dd3et/solar-grid-tie-inverter-MK2/IMAG8995.jpg

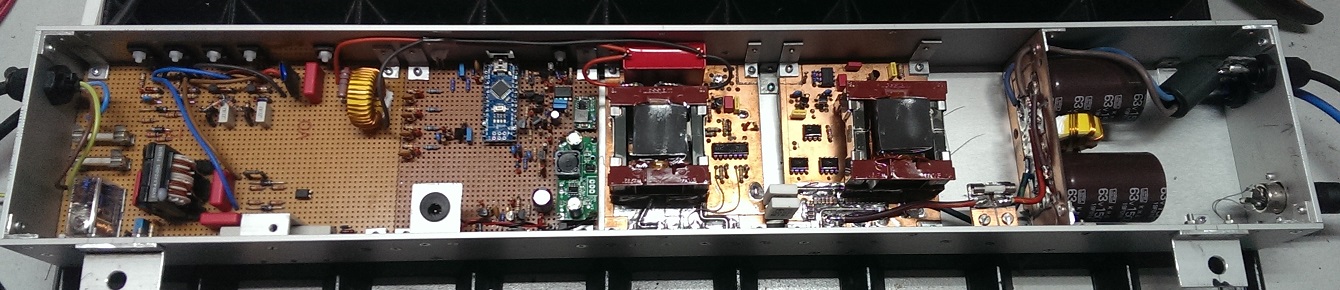
IMAG8995.jpg
