dd3et/solar-grid-tie-inverter-MK2/IMAG8998.jpg

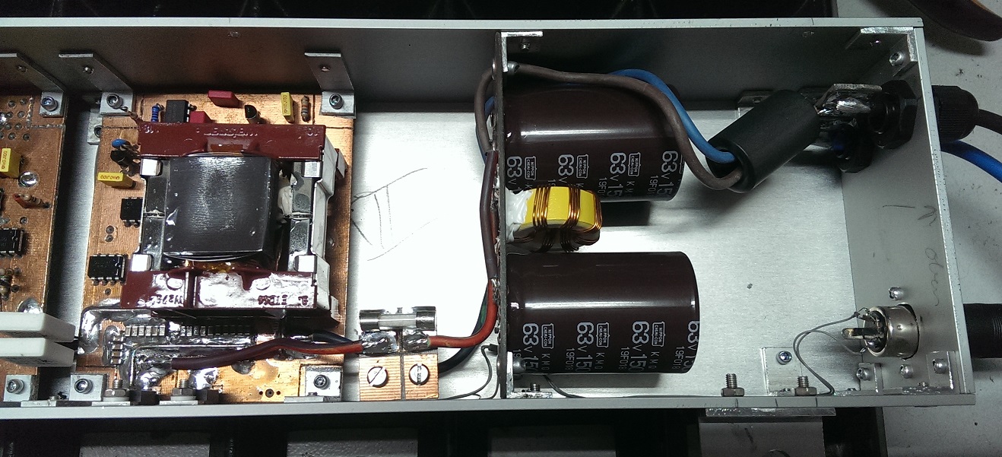
IMAG8998.jpg
