dd3et/solar-grid-tie-inverter-MK2/README.md

# solar-grid-tie-inverter-MK2
Solarwechselrichter für ein Modul wie JKM335M
Dieser Wechseltichter hat eine thermische Nachführung der mpp-Spannung des Solarmoduls.
Kein MPPT.
Unter das Modul wird mittig ein NTC geklebt, der mit dem Wechselrichter verbunden wird.
Der Wechselrichter wird unter dem Modul montiert.
die Begrenzung der Ausgangsleistung kann zwischen 50W ... 300W über den seriellen Monitor eingegeben werden.
Die MPP Spannung kann über den seriellen Monitor während des Betriebes eingegeben werden um den besten MPP zu finden.
Üner den seriellen Monitor werden diverse Betriebsparameter ausgegeben. u.A. die Ausgangsleistung und Modulspannung.
