dd3et/solar-grid-tie-inverter-MK2/IMAG8996.jpg

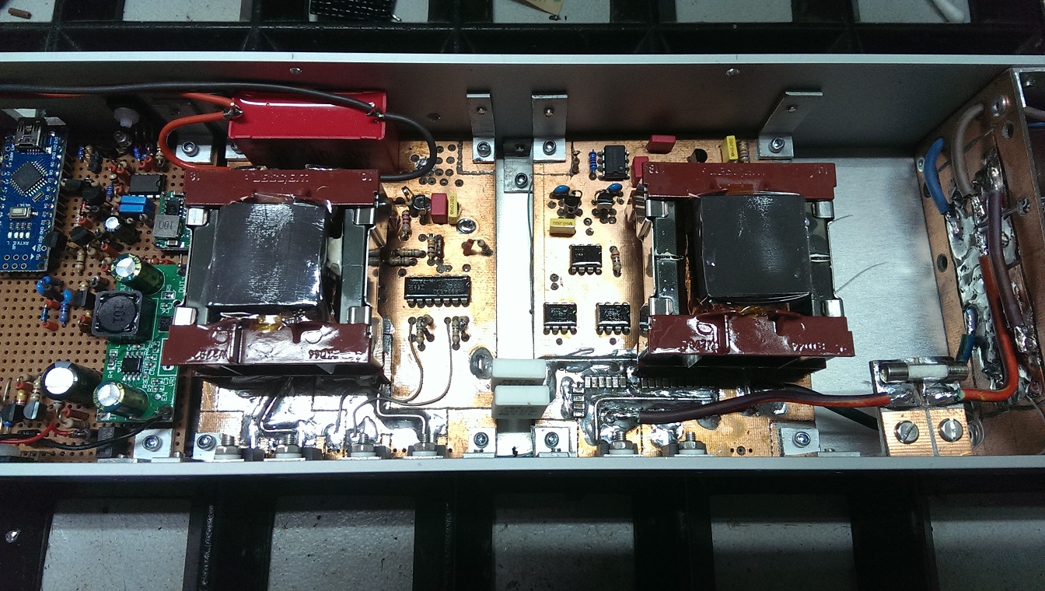
IMAG8996.jpg
