dd3et/solar-grid-tie-inverter-MK2/IMAG8997.jpg

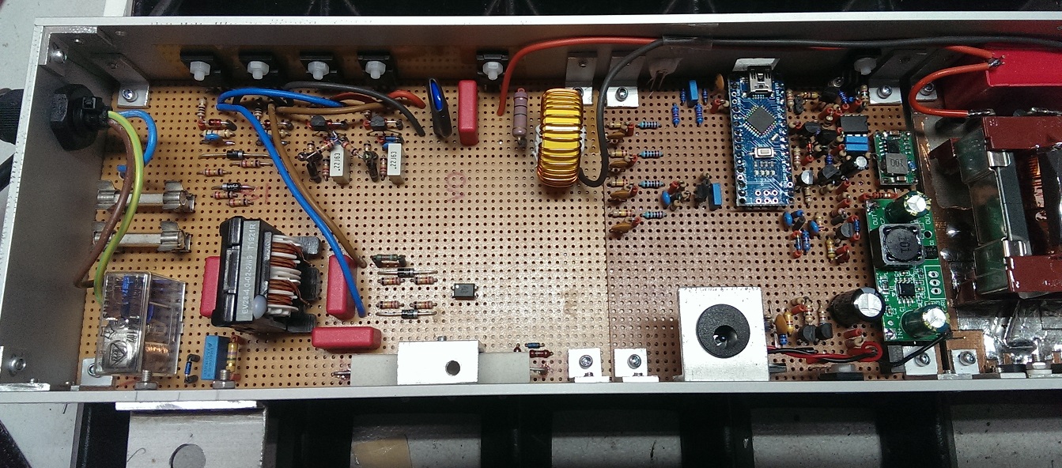
IMAG8997.jpg
