dd3et/solar-grid-tie-inverter-MK2/IMAG9004.jpg

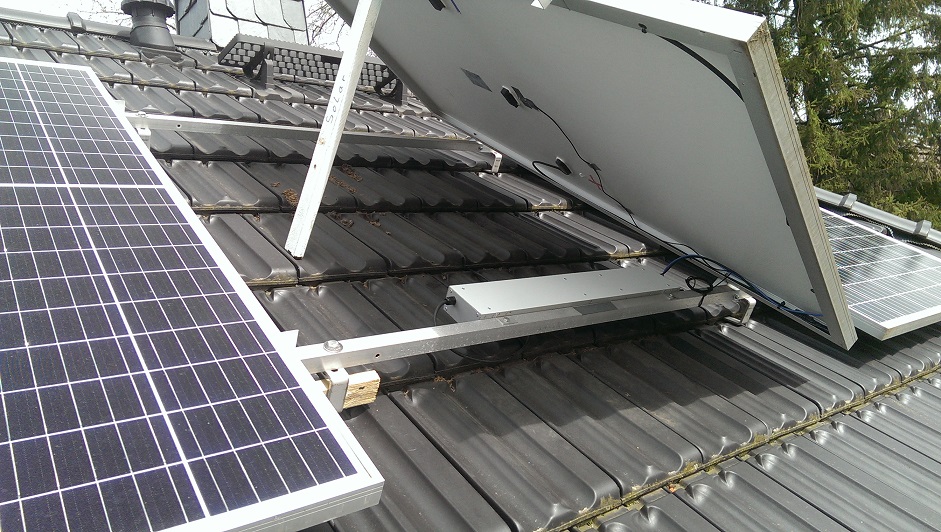
IMAG9004.jpg
