dd3et/solar-grid-tie-inverter-MK2/Solar-grid-tie-inverter-II-IRS-Buck-dcdc-conv-20240331-schema-2v2 .pdf

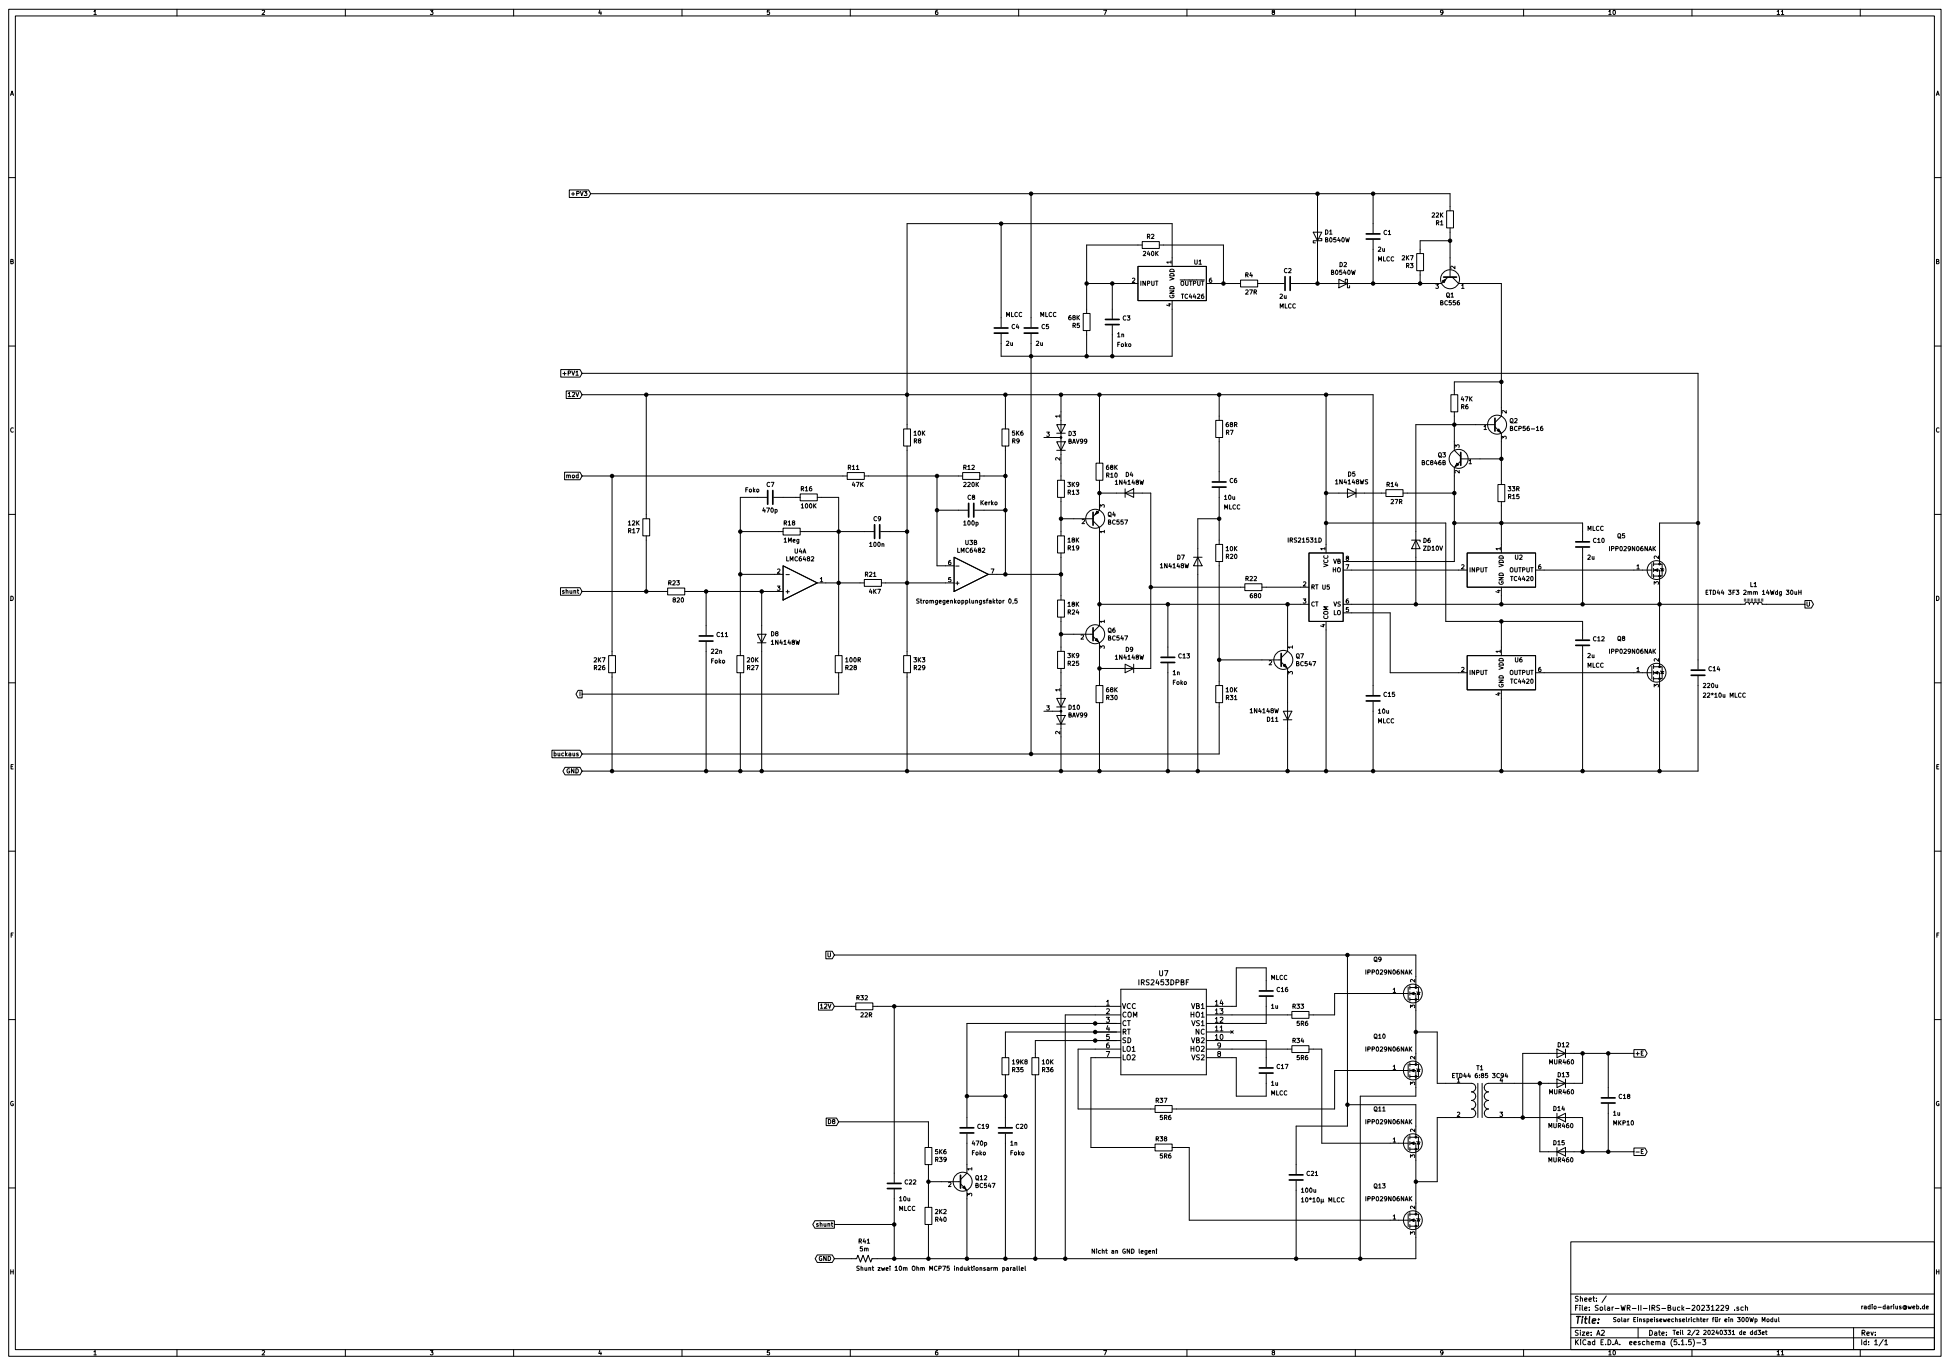
[picture p6: page 1]

7 VB
6 HO 5 VS

Nicht an GND legen!

Shunt zwei 10m Ohm MCP75 induktionsarm parallel

Id: 1/1 Title: File: Solar-WR-II-IRS-Buck-20231229 .sch Sheet: /

radio-darius@web.de
