dd3et/solar-grid-tie-inverter-MK2/Solar-grid-tie-inverter-II-U-Versorgung-Einspeise-20240331-schema-1v2.pdf

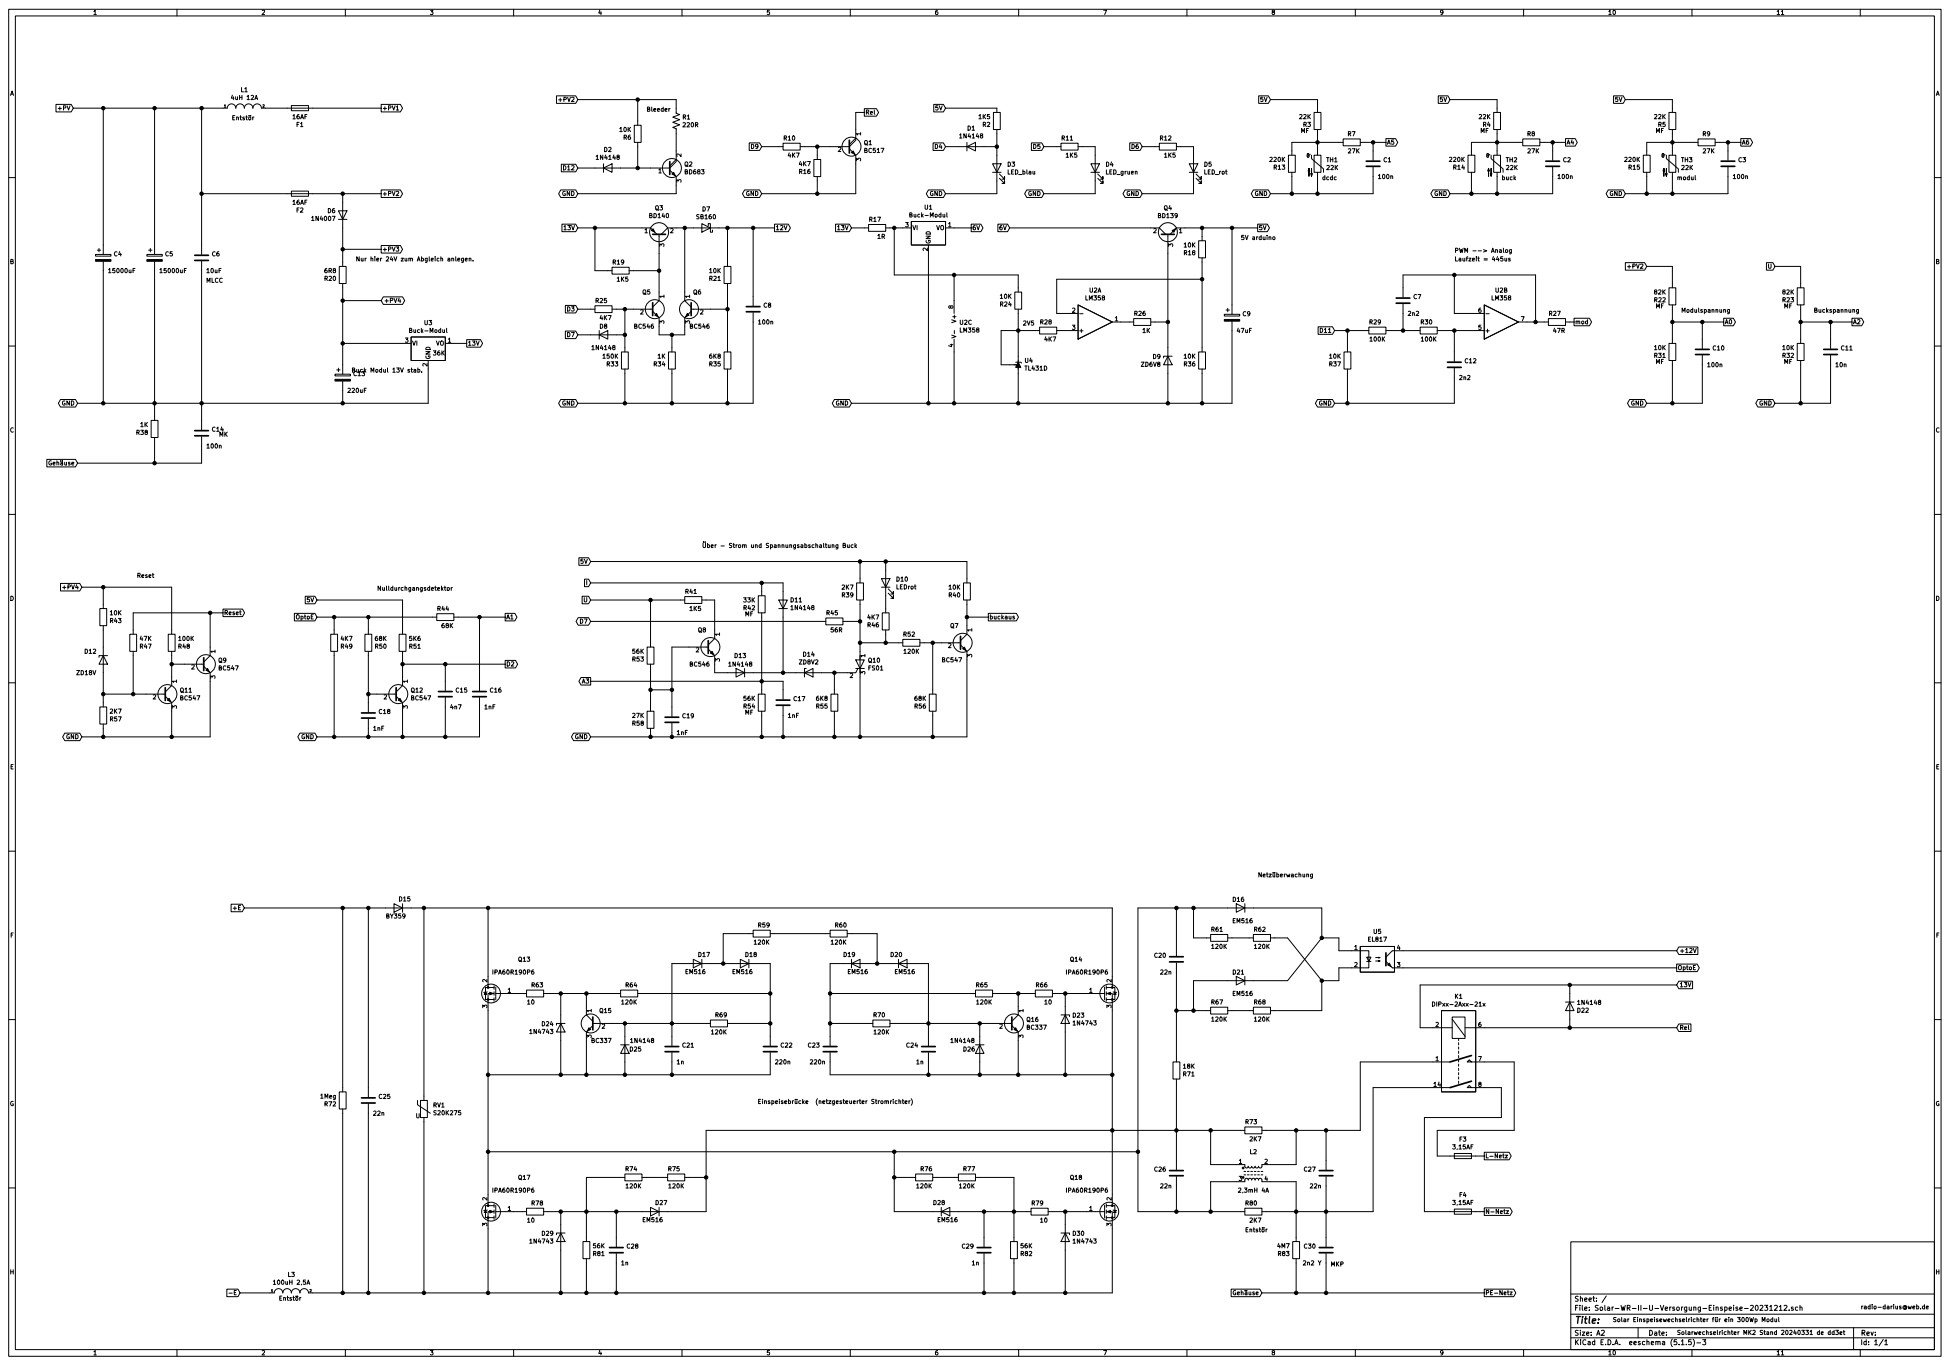
[picture p7: page 1]

Nur hier 24V zum Abgleich anlegen.

File: Solar-WR-II-U-Versorgung-Einspeise-20231212.sch Sheet: /

radio-darius@web.de

Solarwechselrichter MK2 Stand 20240331 de dd3et Solar Einspeisewechselrichter für ein 300Wp Modul
