dd3et/solar-grid-tie-inverter-MK2/Einspeisebruecke-MK2-001.asc

C1: cap; 1n
C2: cap; 220n
C3: cap; 1n
C4: cap; 220n
C5: cap; 1µ
D1: zener; BZX84C12L
D2: diode; 1SR154-600
D3: zener; BZX84C12L
D4: diode; 1SR154-600
D5: zener; BZX84C12L
D6: diode; 1N4148
D7: diode; 1SR154-600
D8: diode; 1SR154-600
D9: zener; BZX84C12L
D10: diode; 1N4148
D11: diode; 1SR154-600
D12: diode; 1SR154-600
D13: diode
D14: diode
D15: diode
D16: diode
D17: diode
D18: diode
M1: nmos; STP8NM60
M2: nmos; STP8NM60
M3: nmos; STP8NM60
M4: nmos; STP8NM60
Q1: npn; 2N2222
Q2: npn; 2N2222
R1: EuropeanResistor; 56K
R2: EuropeanResistor; 10
R3: EuropeanResistor; 120K
R4: EuropeanResistor; 120K
R5: EuropeanResistor; 56K
R6: EuropeanResistor; 10
R7: EuropeanResistor; 120K
R8: EuropeanResistor; 120K
R9: EuropeanResistor; 120K
R10: EuropeanResistor; 120K
R11: EuropeanResistor; 120K
R12: EuropeanResistor; 120K
R13: EuropeanResistor; 120K
R14: EuropeanResistor; 120K
R15: EuropeanResistor; 200
R16: EuropeanResistor; 100K
R18: EuropeanResistor; 10
R19: EuropeanResistor; 10
V1: voltage; SINE(0 325 50)
V2: voltage; PULSE(0 700 850µ 100µ 100µ 8m 10m); Rser=1
V3: voltage; SINE(0 700 50); Rser=1
Named nets: 0, N, L, gm4, gm3, gm2, gm1, i
.tran 0 1 900m
IPA60R190P6
IPA60R190P6
IPA60R190P6
IPA60R190P6
1N4743
1N4743
1N4743
1N4743
EM516
EM516
EM516
EM516
EM516
EM516
Ersatzschaltung für den dcdc-converter für die Simulation
