dd3et/solar-grid-tie-inverter-MK2/NE555-014.asc

A1: schmitt; Vlow=0 Vhigh=12 Vt=6 Vh=100m
C1: cap; 10n
C2: cap; 10n
C3: cap; 2.2n
C4: cap; 100p
C5: cap; 100µ
C6: cap; 1n
C7: cap; 1n
D1: diode; 1N4148
D2: diode; 1N4148
D3: diode; 1N4148
D4: diode; 1N4148
D5: diode; 1N4148
D6: diode; 1N4148
D7: diode; 1N4148
L1: ind; 300µ
Q1: pnp; BC557C
Q2: npn; BC547C
R1: EuropeanResistor; 220K
R2: EuropeanResistor; 10K
R3: EuropeanResistor; 680
R4: EuropeanResistor; 3.9K
R5: EuropeanResistor; 47K
R6: EuropeanResistor; 120K
R7: EuropeanResistor; 10K
R8: res; 1
R9: EuropeanResistor; 3.3K
R10: EuropeanResistor; 18K
R11: EuropeanResistor; 3.9K
R12: EuropeanResistor; 18K
R13: EuropeanResistor; 4.7K
R14: EuropeanResistor; 10K
R15: EuropeanResistor; 68K
R16: EuropeanResistor; 68K
R17: EuropeanResistor; 5.6K
U1: NE555
U2: LTC6240
V1: voltage; 12.3
V2: voltage; SINE(2.5 2.5 100)
V3: voltage; SINE(4 4 100)
Named nets: 0, demod, ausg, c, mod, op
.tran 0 50m 20m 1µ
1n
30µH
